A1b3rt-314/SIX_Q---Mini-Greenhouse/images/033.jpg

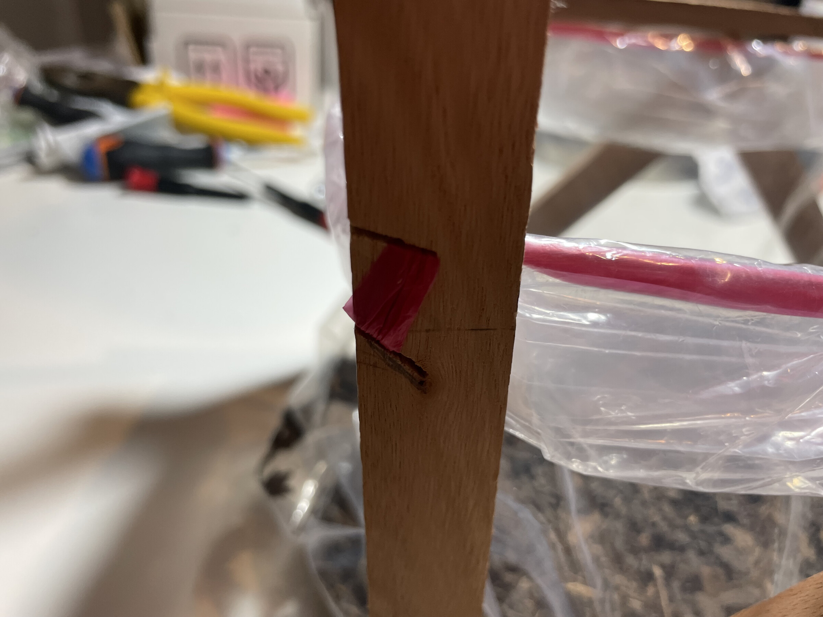
images/033.jpg
