A1b3rt-314/SIX_Q---Mini-Greenhouse/images/037.jpg

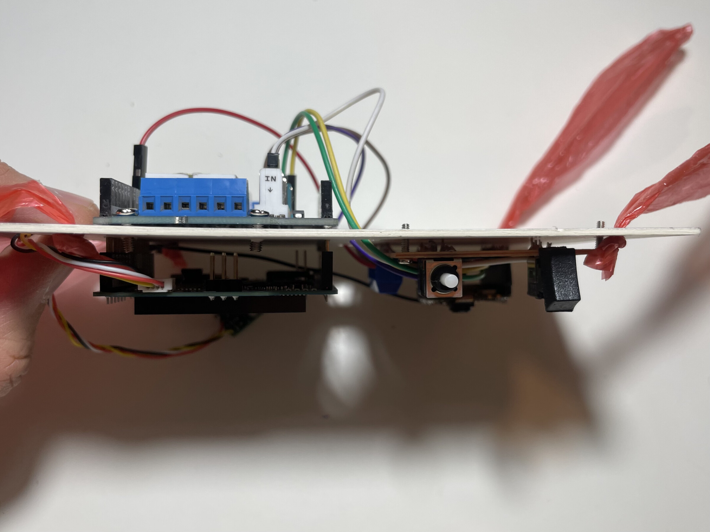
images/037.jpg
