A1b3rt-314/SIX_Q---Mini-Greenhouse/images/048.jpg

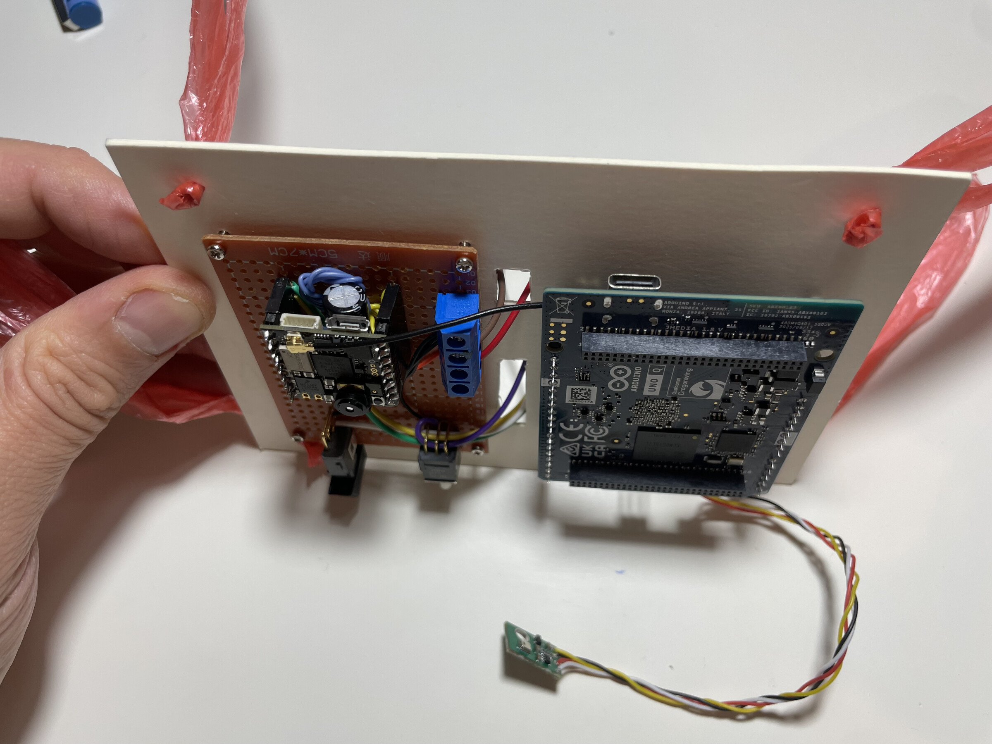
images/048.jpg
