A1b3rt-314/SIX_Q---Mini-Greenhouse/images/060.jpg

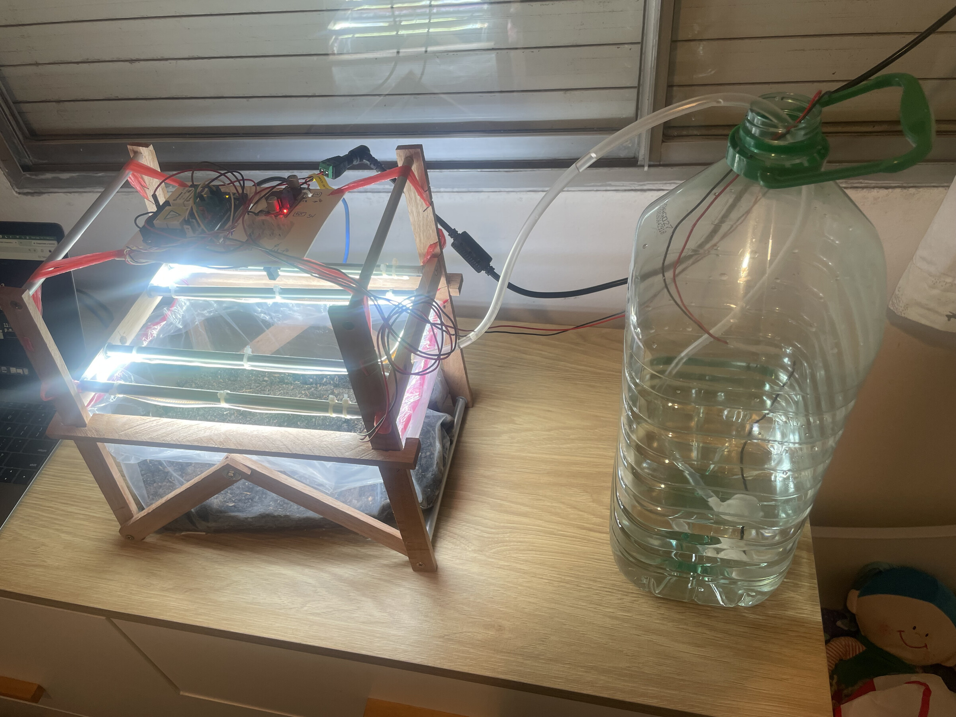
images/060.jpg
