A1b3rt-314/SIX_Q---Mini-Greenhouse/images/063.jpg

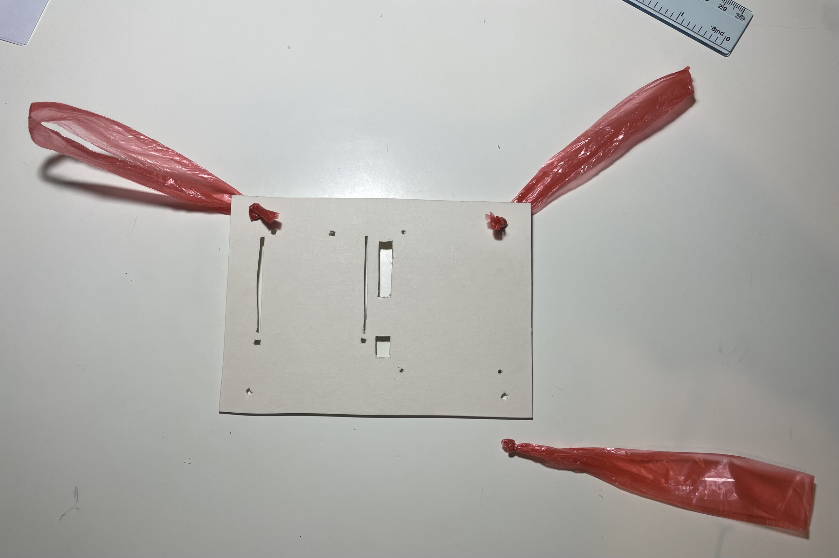
images/063.jpg
