A1b3rt-314/SIX_Q---Mini-Greenhouse/images/064.jpg

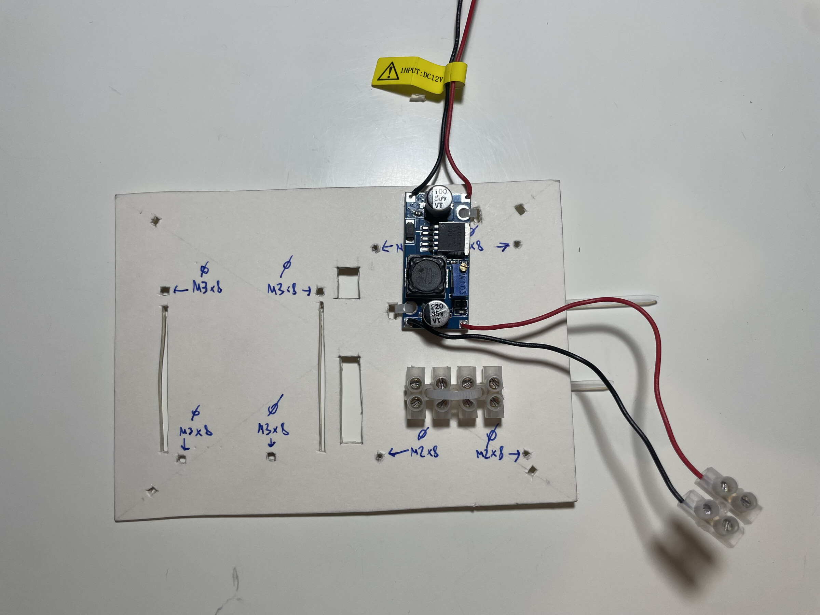
images/064.jpg
