A1b3rt-314/SIX_Q---Mini-Greenhouse/images/068.jpg

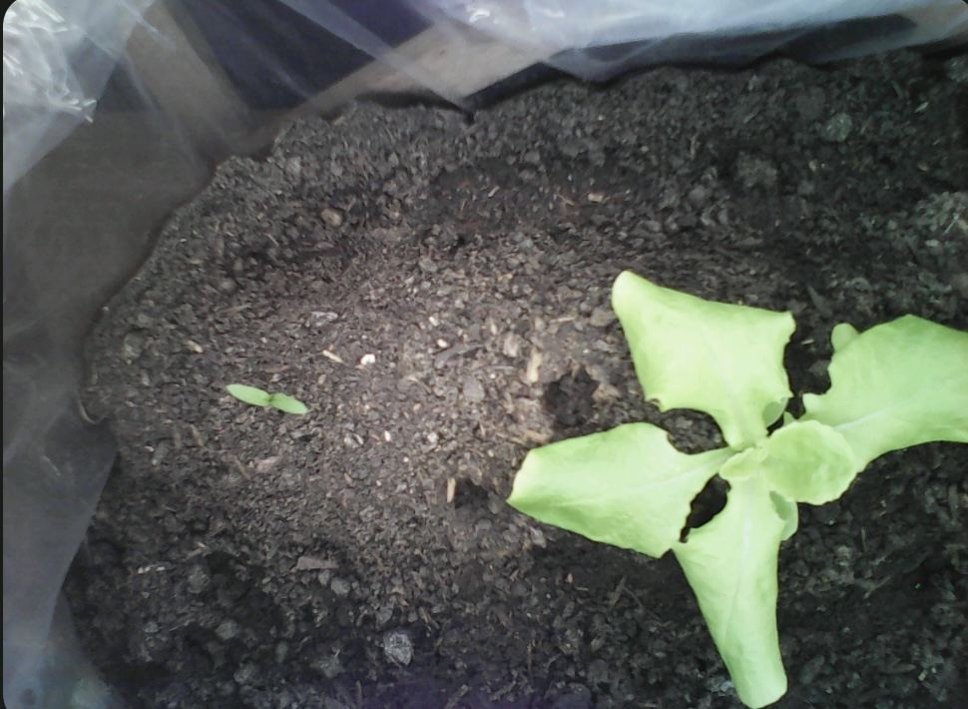
images/068.jpg
