A1b3rt-314/SIX_Q---Mini-Greenhouse/design/Barra_lateral.stl

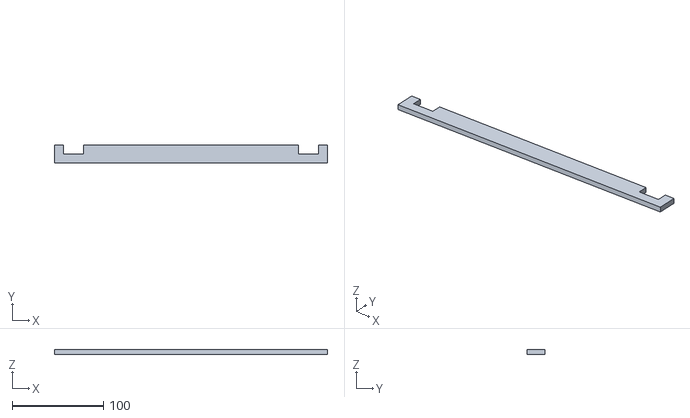
[picture p13: CAD file, 2026-10-10]
design/Barra_lateral.stl
300.0 x 20.0 x 5.00
