A1b3rt-314/SIX_Q---Mini-Greenhouse/design/Base_x4.stl

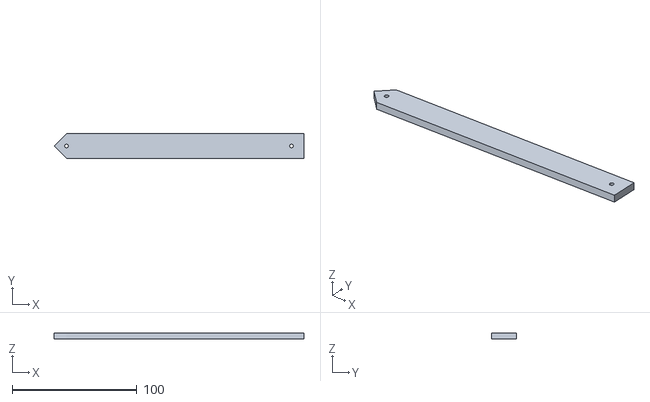
[picture p15: CAD file, 2026-10-10]
design/Base_x4.stl
200.0 x 20.0 x 5.00
