A1b3rt-314/SIX_Q---Mini-Greenhouse/design/Pilar_x4.stl

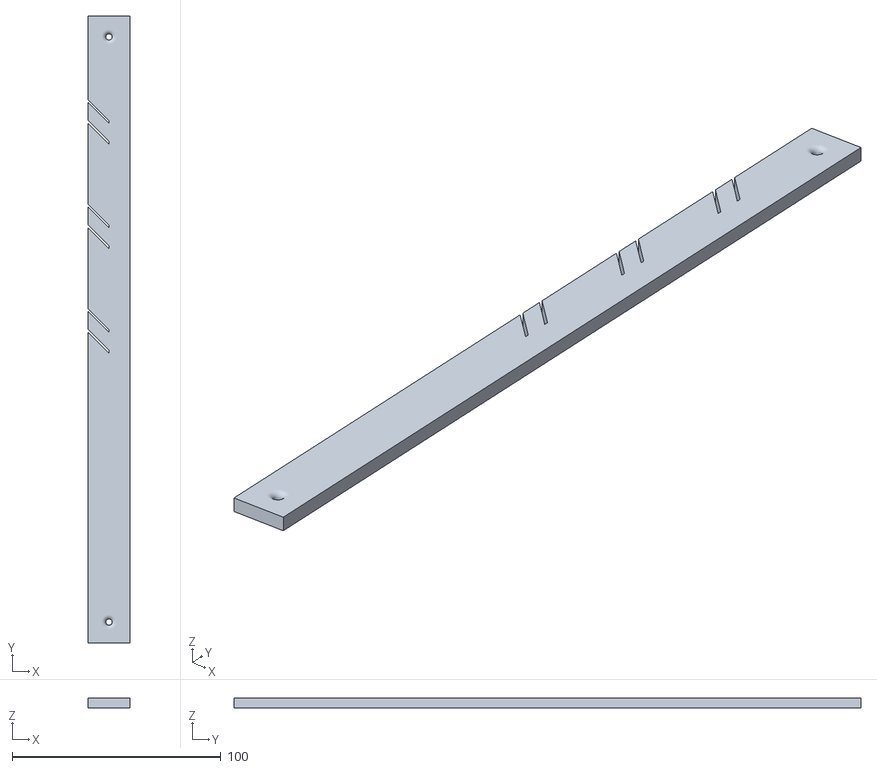
[picture p16: CAD file, 2026-10-10]
design/Pilar_x4.stl
20.0 x 300.0 x 5.00
