A1b3rt-314/SIX_Q---Mini-Greenhouse/design/Soporte_luz_y_riego_x2.stl

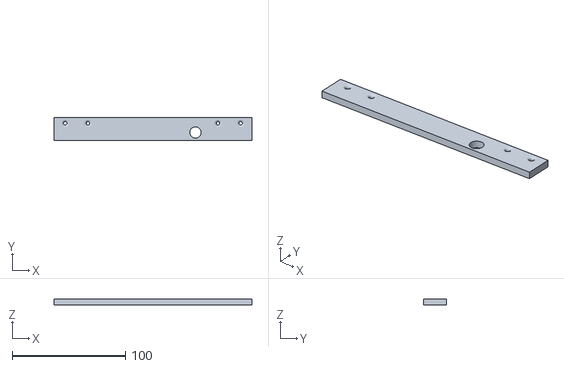
[picture p17: CAD file, 2026-10-10]
design/Soporte_luz_y_riego_x2.stl
175.0 x 20.0 x 5.00
