A1b3rt-314/SIX_Q---Mini-Greenhouse/design/Soporte_electronica_2mm.stl

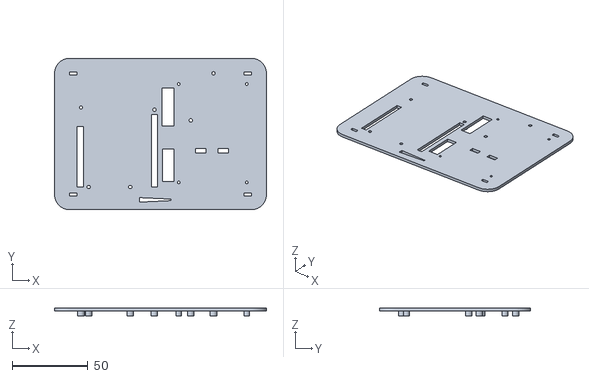
[picture p18: CAD file, 2026-10-10]
design/Soporte_electronica_2mm.stl
140.0 x 100.0 x 5.00
