A1b3rt-314/SIX_Q---Mini-Greenhouse/(list of files, cad)

Other CAD files:
design/Barra_lateral.f3d
design/Base_x4.f3d
design/Pilar_x4.f3d
design/Soporte_electronica.f3d
design/Soporte_luz_y_riego_x2.f3d
