A1b3rt-314/SIX_Q---Mini-Greenhouse/CIRCUIT DIAGRAM.pdf

# SIX_Q Mini Greenhouse

# Irrigation

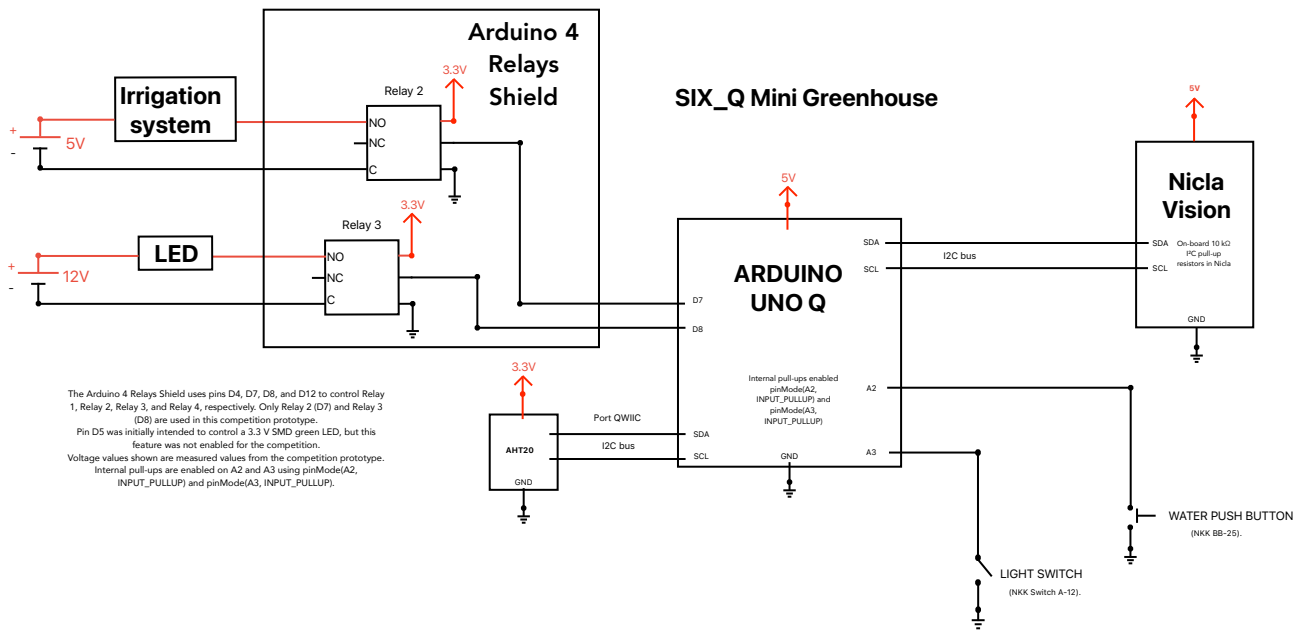
[picture p75: page 1]
ARDUINO UNO Q; GND; SCL; SDA; LED; Relay 3; system; Relay 2; AHT20; Nicla Vision; I2C bus; LIGHT SWITCH; (NKK Switch A-12).; (NKK BB-25).; Port QWIIC; Internal pull-ups enabled pinMode(A2, INPUT_PULLUP) and pinMode(A3, INPUT_PULLUP); Arduino 4 Relays Shield

On-board 10 kΩ
SDA

I²C pull-up
resistors in Nicla
SCL

The Arduino 4 Relays Shield uses pins D4, D7, D8, and D12 to control Relay
1, Relay 2, Relay 3, and Relay 4, respectively. Only Relay 2 (D7) and Relay 3

(D8) are used in this competition prototype.

Pin D5 was initially intended to control a 3.3 V SMD green LED, but this

feature was not enabled for the competition.

Voltage values shown are measured values from the competition prototype.
Internal pull-ups are enabled on A2 and A3 using pinMode(A2,
INPUT_PULLUP) and pinMode(A3, INPUT_PULLUP).

WATER PUSH BUTTON
