A1b3rt-314/SIX_Q---Mini-Greenhouse/design/Barra_lateral_x2.pdf

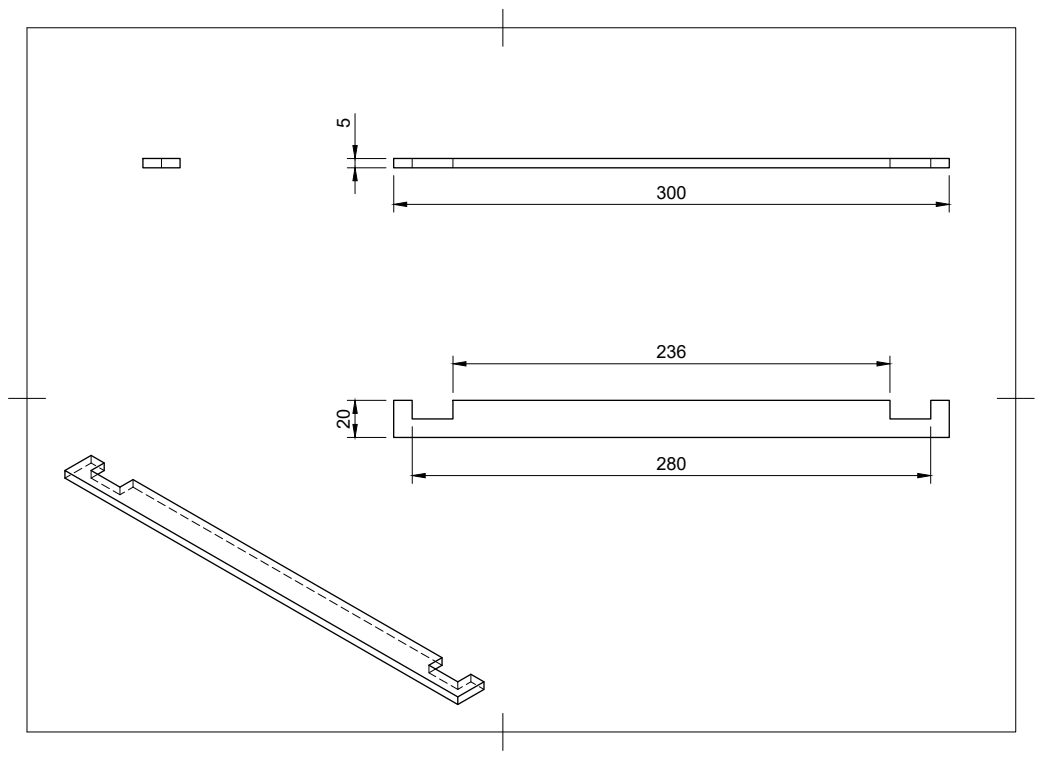
[picture p76: page 1]
