A1b3rt-314/SIX_Q---Mini-Greenhouse/design/Base_x4.pdf

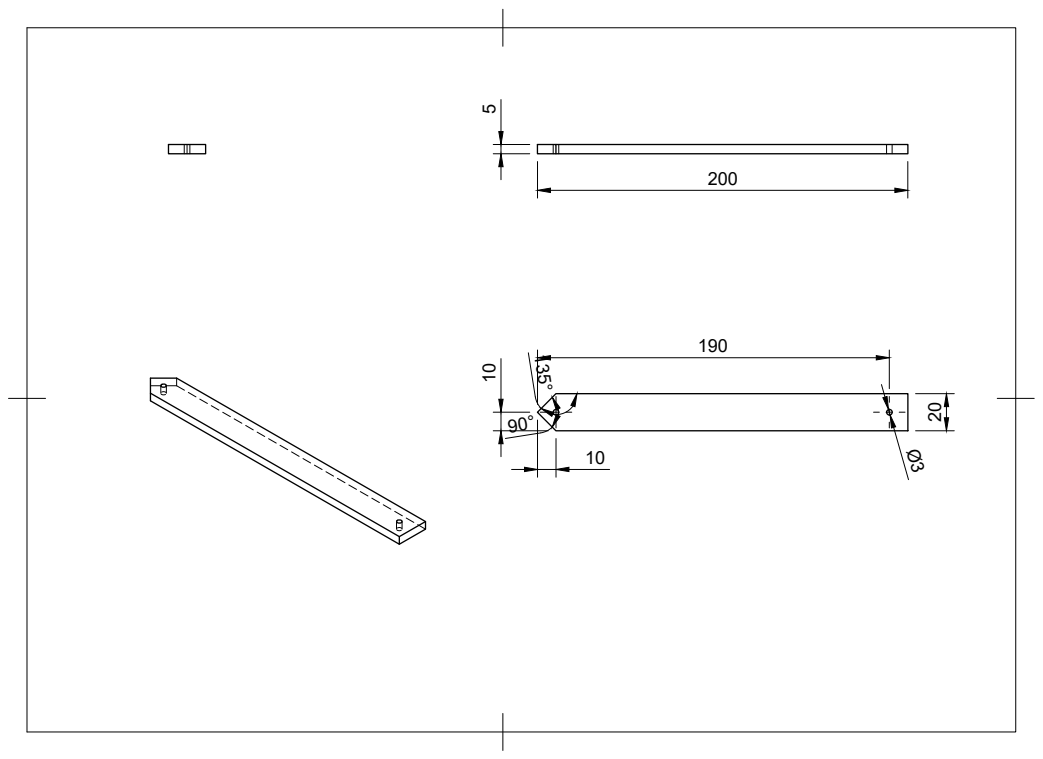
[picture p77: page 1]
