A1b3rt-314/SIX_Q---Mini-Greenhouse/design/Pilar_x4.pdf

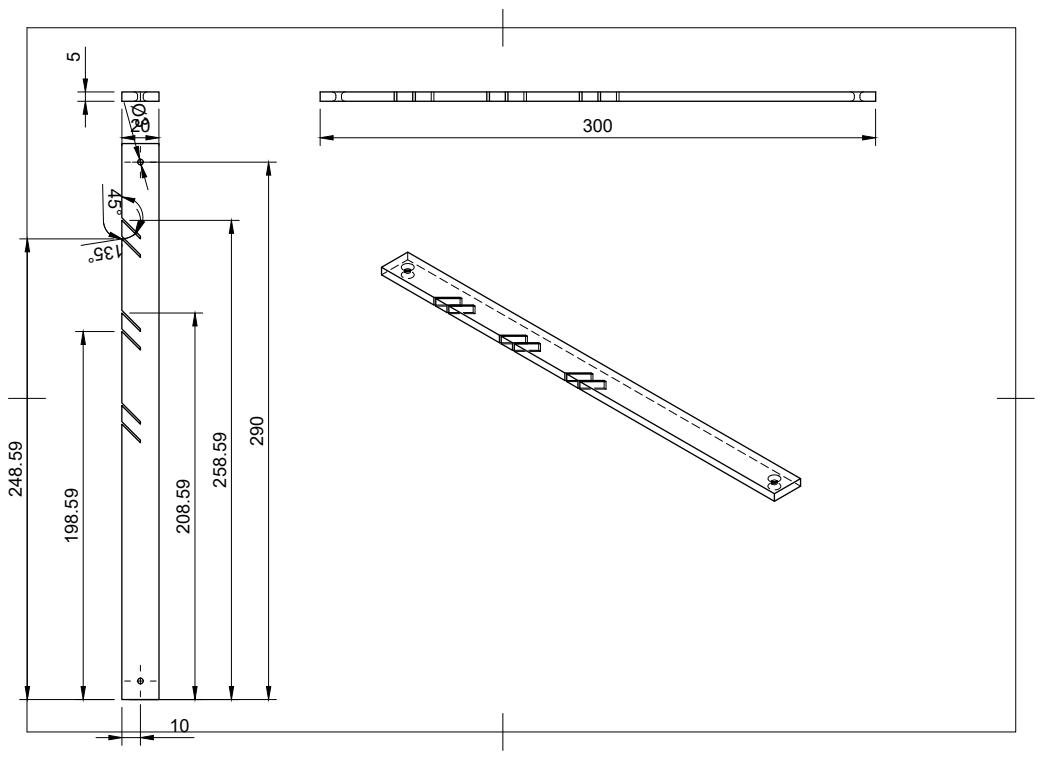
[picture p78: page 1]
