A1b3rt-314/SIX_Q---Mini-Greenhouse/design/Soporte_electronica_x1.pdf

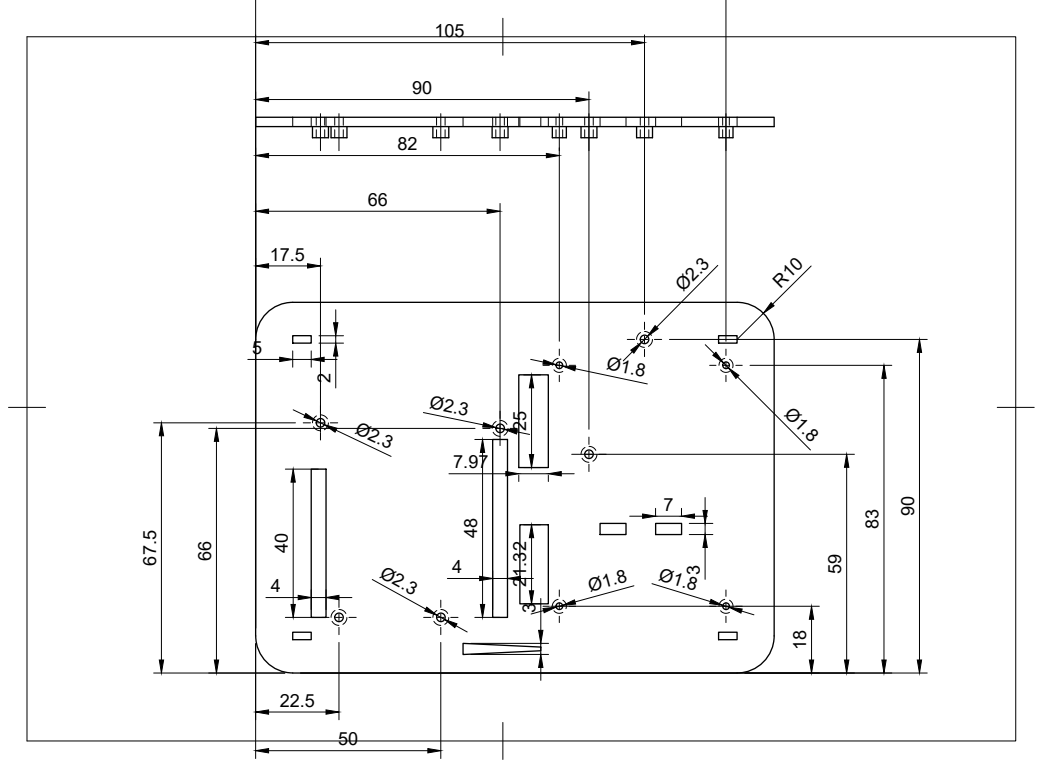
[picture p79: page 1]
