A1b3rt-314/SIX_Q---Mini-Greenhouse/design/Soporte_luz_y_riego_x2.pdf

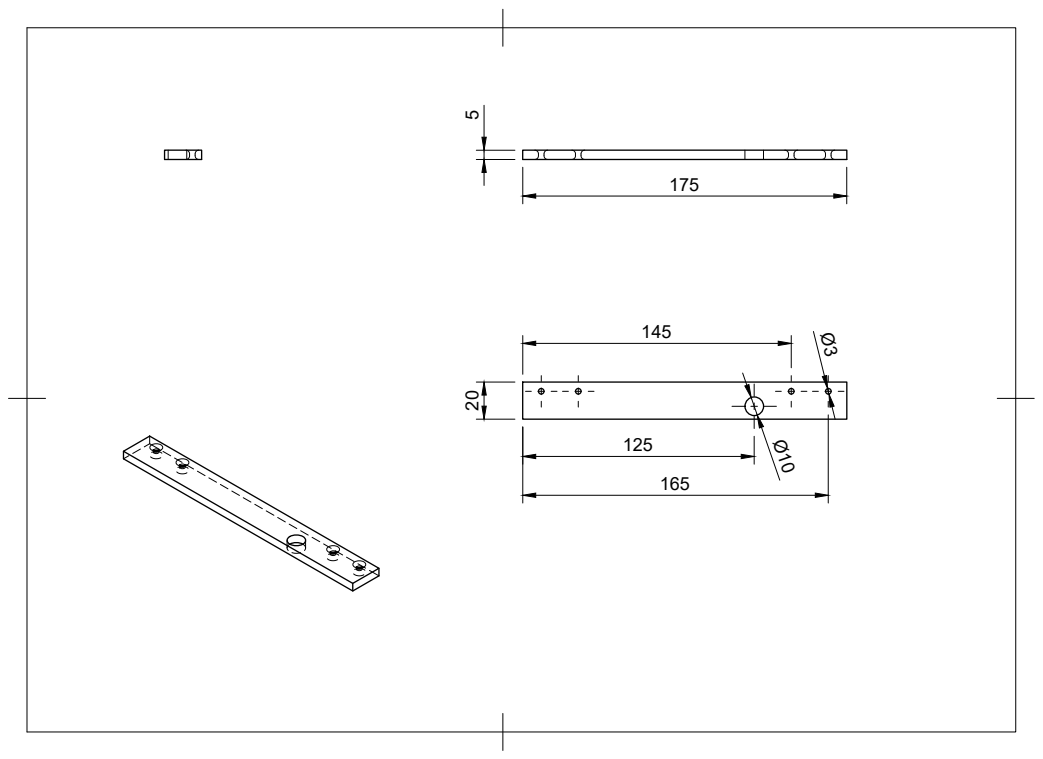
[picture p80: page 1]
