A1b3rt-314/SIX_Q---Mini-Greenhouse/Nicla_Vision/secrets.example.h

#define WIFI_SSID "XXXXXXXXXX"
#define WIFI_PASSWORD "YYYYYYYYYY"

#define UNO_Q_IP_1 00
#define UNO_Q_IP_2 00
#define UNO_Q_IP_3 00
#define UNO_Q_IP_4 000
#define UNO_Q_PORT 5000

// SIX_Q Vision: must match AUTH_SHARED_KEY in
// Arduino_UNO_Q/secrets_auth.py exactly. Never sent over I2C in cleartext.

#define AUTH_SHARED_KEY "ZZZZZZZZZZZ"
